iAdam368/arduino-button-presser/docs/costs.csv

Item | Supplier | Qty needed | Qty bought | Cost (GBP) | Included in total | Link | Notes
Elegoo UNO R3 board | Amazon UK | 1 | 1 | 12.1 | Yes | [LINK] | Arduino-compatible board
4x 28BYJ-48 motors with 4x ULN2003 driver boards | Amazon UK | 1 | 4 | 9.99 | Yes | [LINK] | Motor and driver boards come together
Elegoo 120pc jumper wire kit | Amazon UK | 6 | 120 | 5.63 | Yes | [LINK] | Male-to-male and female-to-female wires
3M double-sided tape | Amazon UK | 1 | 1 | 2.5 | Yes | [LINK] | Approximate price; cheaper options exist
Bottle cap plastic (button finger) | n/a | 1 | 1 | 0 | Yes | n/a | Cut from a bottle cap
USB power bank 10000 mAh | Amazon UK | 1 | 1 |  | No | [LINK] | Optional; can use a PC USB port or wall adapter instead; most are under 20 GBP
USB cable (A to B) | n/a | 1 | 1 |  | No | n/a | Needed for programming; often included with the board
TOTAL (parts included above) |  |  |  | 30.22
