iAdam368/arduino-button-presser/(commit log)

2026-11-10 Add image mounted-on-thermostat.jpg
2026-11-10 Add wiring diagram
2026-11-10 Add costs spreadsheet
    [costs.csv]
2026-11-10 Revise README with updated wiring and part links
